HuberGiron/cnc/motores-y-mecanismos.md

---
layout: default
title: Mecanismos
nav_order: 3
---

# Motores y mecanismos de transmisión

Una CNC necesita convertir el movimiento rotativo del motor en **movimiento lineal controlado**. Esa conversión puede lograrse con distintos mecanismos, y la elección del mecanismo afecta directamente la velocidad, el empuje, la rigidez, la precisión, la longitud de recorrido y el costo del eje [1], [2].

<div class="content-media ratio-16x9">
  <iframe
    src="https://www.youtube.com/embed/OAEwRMqpst0"
    title="Video sobre motores y mecanismos CNC"
    allow="accelerometer; autoplay; clipboard-write; encrypted-media; gyroscope; picture-in-picture; web-share"
    allowfullscreen>
  </iframe>
</div>

En esta sección se comparan tres mecanismos muy comunes en máquinas CNC y automatización ligera:

- **Husillo**,
- **Banda dentada**,
- **Engrane-cremallera**.

También se aclara el papel de las **guías lineales**, ya que con frecuencia se confunden con la transmisión aunque cumplen otra función.

## 1. Motor a pasos

En máquinas CNC de prototipado es muy común usar **motores a pasos** (*stepper motors*). Se utilizan porque permiten construir sistemas de movimiento relativamente simples, económicos y suficientemente precisos para muchas tareas de posicionamiento en ejes X, Y y Z.

Motores NEMA 1

Un motor a pasos no gira “libremente” como un motor DC convencional, sino que avanza en **incrementos angulares discretos** llamados **pasos**. Internamente, el driver energiza sus bobinas en una secuencia determinada, generando campos magnéticos que hacen que el rotor avance de una posición estable a la siguiente. Por eso, cada pulso enviado al sistema produce un pequeño avance angular del eje del motor.

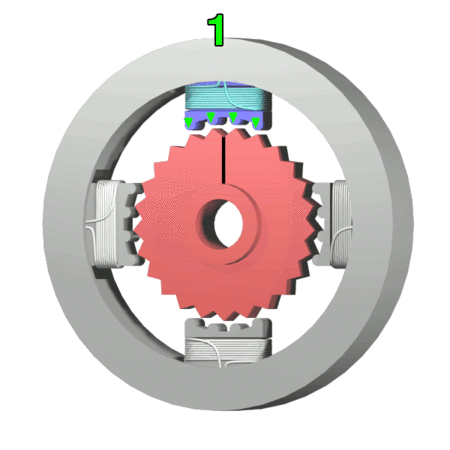
[picture p60: assets/img/mecanismos/motor_a_pasos.webp]
Motores NEMA 17


En muchos motores NEMA 17 usados en CNC, el ángulo típico por paso es de **1.8°**, lo que significa que se requieren:

- **200 pasos por vuelta** para completar 360°
- porque: **360° / 1.8° = 200**

Este concepto es fundamental en CNC, porque el controlador no mueve directamente “10 mm”; en realidad genera una cierta cantidad de pulsos. Después, mediante la transmisión mecánica, esos pasos del motor se convierten en desplazamiento lineal del eje.

### ¿Qué tienen que ver los pasos con el movimiento lineal?

El motor produce **movimiento rotativo discreto**, pero la máquina necesita **movimiento lineal controlado**. Por eso se usa un mecanismo intermedio, por ejemplo:

- **Banda dentada**
- **Husillo**
- **Piñon-cremallera**

La relación entre los pasos del motor y el desplazamiento lineal depende del mecanismo de transmisión.

Por ejemplo, si un motor de **200 pasos/vuelta** mueve una polea GT2 de **20 dientes** con banda de **2 mm de paso**, entonces una vuelta completa produce:

**20 × 2 = 40 mm/vuelta**

Por lo tanto, cada paso completo del motor desplaza idealmente:

**40 mm / 200 = 0.2 mm por paso**

### ¿Por qué se usan motores a pasos en CNC?

Los motores a pasos son muy populares en CNC educativas, de escritorio y de prototipado por varias razones:

1. **Permiten posicionamiento incremental sencillo**  
   El controlador solo necesita contar pulsos para estimar la posición del motor.

2. **Tienen buen torque a bajas velocidades**  
   Esto es útil en ejes que deben arrancar, detenerse y mantener posición con frecuencia.

3. **Pueden sostener posición cuando están energizados**  
   Esto ayuda a mantener el eje en su lugar sin necesidad de un freno mecánico adicional en muchos casos.

4. **Se integran fácilmente con controladores como GRBL**  
   Sistemas como Arduino + CNC Shield + A4988/DRV8825 generan señales STEP/DIR de forma directa y sencilla.

5. **Tienen bajo costo y gran disponibilidad**  
   Son fáciles de conseguir, documentar y reemplazar.

### Limitaciones importantes

Aunque son muy útiles, los motores a pasos también tienen limitaciones. Si se les exige demasiada velocidad, aceleración o carga, pueden **perder pasos**. Cuando eso ocurre, el controlador sigue creyendo que el eje está donde debería, pero mecánicamente ya no coincide con la posición real. Por eso, en una CNC bien ajustada es importante definir correctamente:

- Corriente del driver,
- Aceleraciones,
- Velocidad máxima,
- Tipo de transmisión,
- Masa móvil,
- Rigidez del sistema.

Por eso, al diseñar una CNC no basta con elegir un “motor potente”; hay que entender cómo sus pasos se traducen en movimiento lineal útil dentro de una arquitectura mecánica completa.

## 2. Husillo

El sistema por **husillo** convierte la rotación en avance lineal mediante un tornillo y una tuerca. En la práctica pueden encontrarse variantes como **lead screw**, **Acme** y **ball screw**. Cada vuelta del eje produce un avance lineal determinado por el paso o el lead del tornillo [1].

### Ventajas típicas del husillo

- Buen empuje axial,
- Buena relación entre rotación y avance,
- Buena rigidez para recorridos cortos o medianos,
- Buena solución cuando importa más el control del avance que la velocidad máxima.

### Limitaciones típicas del husillo

- Menor velocidad que una banda en recorridos largos,
- Restricciones por velocidad crítica en tornillos largos,
- Mayor sensibilidad a desalineación,
- Menor conveniencia cuando el recorrido crece mucho.

En general, el husillo suele ser una solución atractiva cuando se busca mayor capacidad de carga, mejor control del avance o una respuesta más rígida que la de una banda [1], [3].

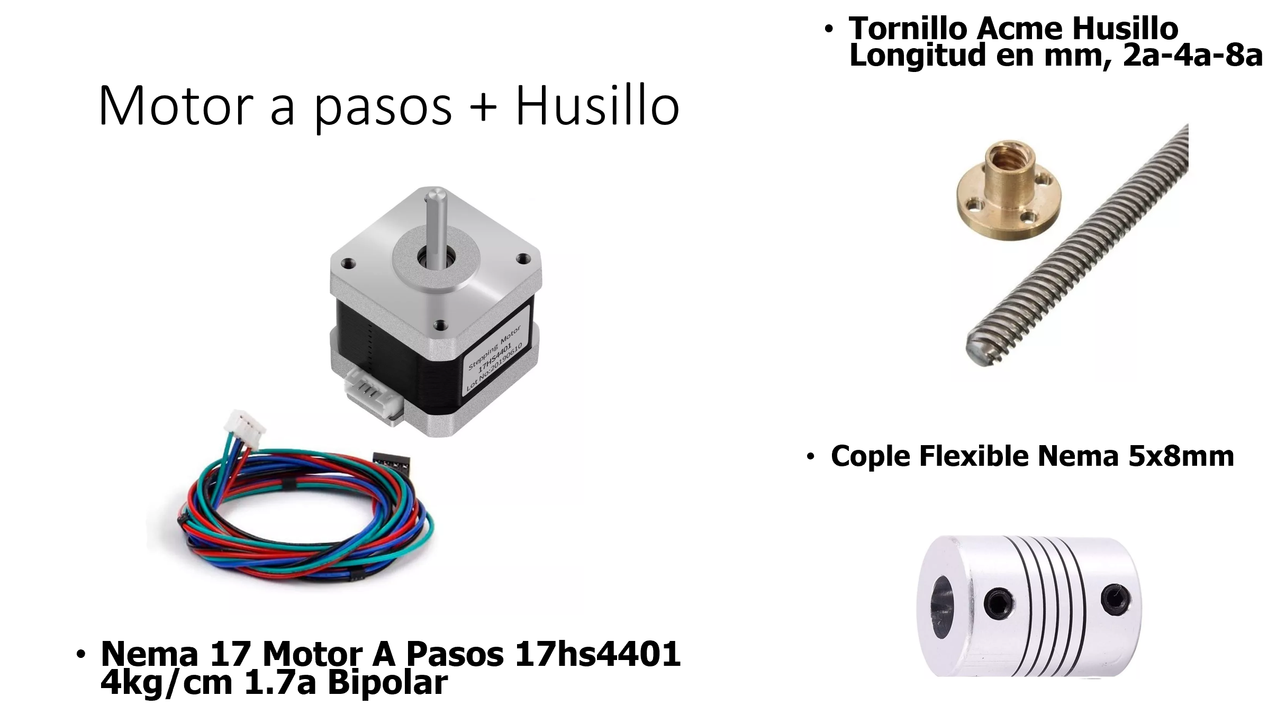
[picture p61: assets/img/mecanismos/componentes_husillo.png]
Componentes Husillo


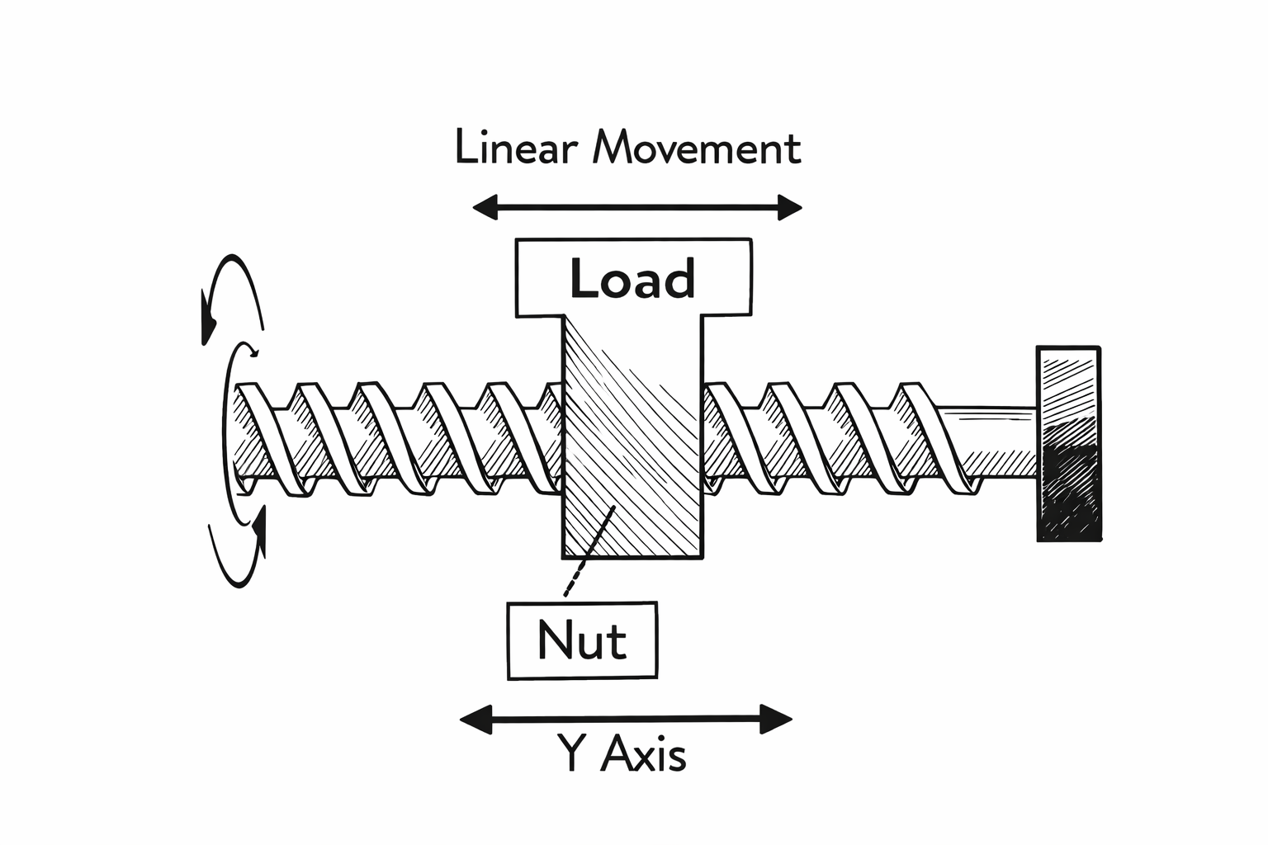
[picture p62: assets/img/mecanismos/husillo2.png]
Husillo


## 3. Banda dentada

En un sistema por **banda dentada**, el motor mueve una polea y la polea arrastra una banda sincronizada que desplaza el carro. Es una solución muy común en ejes largos y ligeros porque es simple, rápida y fácil de integrar [1].

### Ventajas típicas de la banda

- Alta velocidad,
- Buena aceleración,
- Buena solución para recorridos largos,
- Menor masa rotacional que un husillo largo,
- Costo relativamente accesible.

### Limitaciones típicas de la banda

- Menor rigidez que un husillo o algunas soluciones por cremallera,
- Sensibilidad a la tensión de banda,
- Posibilidad de elongación o elasticidad del sistema,
- Menor empuje axial disponible.

Por eso la banda dentada es muy común en routers ligeros, plotters, cortadoras y mecanismos donde interesa más la dinámica del eje que el empuje máximo [1], [2].

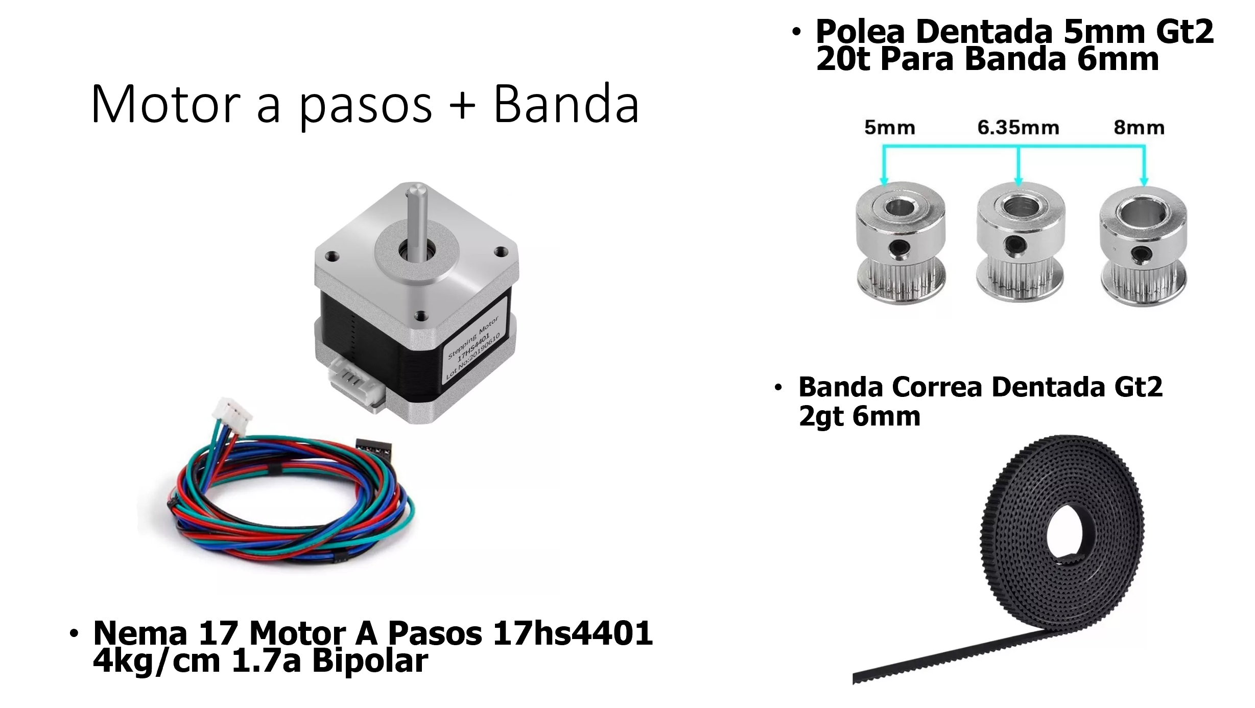
[picture p63: assets/img/mecanismos/componentes_banda.png]
Componentes Banda


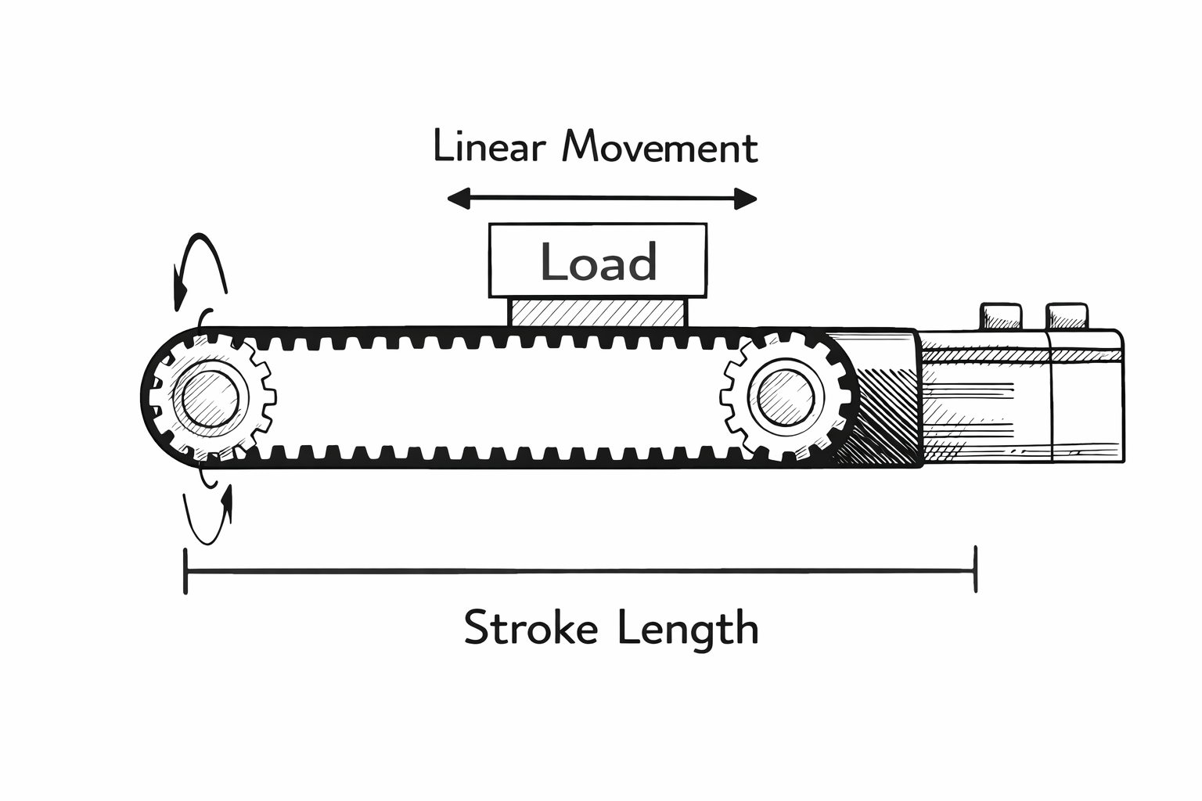
[picture p64: assets/img/mecanismos/banda.png]
Banda


## 4. Piñon-cremallera

El sistema de **piñon-cremallera** usa un piñón rotativo acoplado a una barra dentada lineal. Esta solución es muy utilizada cuando el recorrido se vuelve demasiado largo para que el husillo sea conveniente o cuando se requieren ejes largos, dinámicos y robustos [2], [4].

### Ventajas típicas de la cremallera

- Buena solución para largos recorridos,
- Buena rigidez estructural del sistema,
- Buen desempeño dinámico,
- Posibilidad de sistemas precargados para reducir backlash.

### Limitaciones típicas de la cremallera

- Mayor complejidad mecánica,
- Necesidad de buena alineación,
- Atención al backlash si no se precarga,
- Mayor costo que soluciones simples de banda en máquinas ligeras.

En aplicaciones industriales, la cremallera se vuelve muy competitiva cuando la longitud del eje es alta y la máquina necesita conservar rigidez y repetibilidad [4].

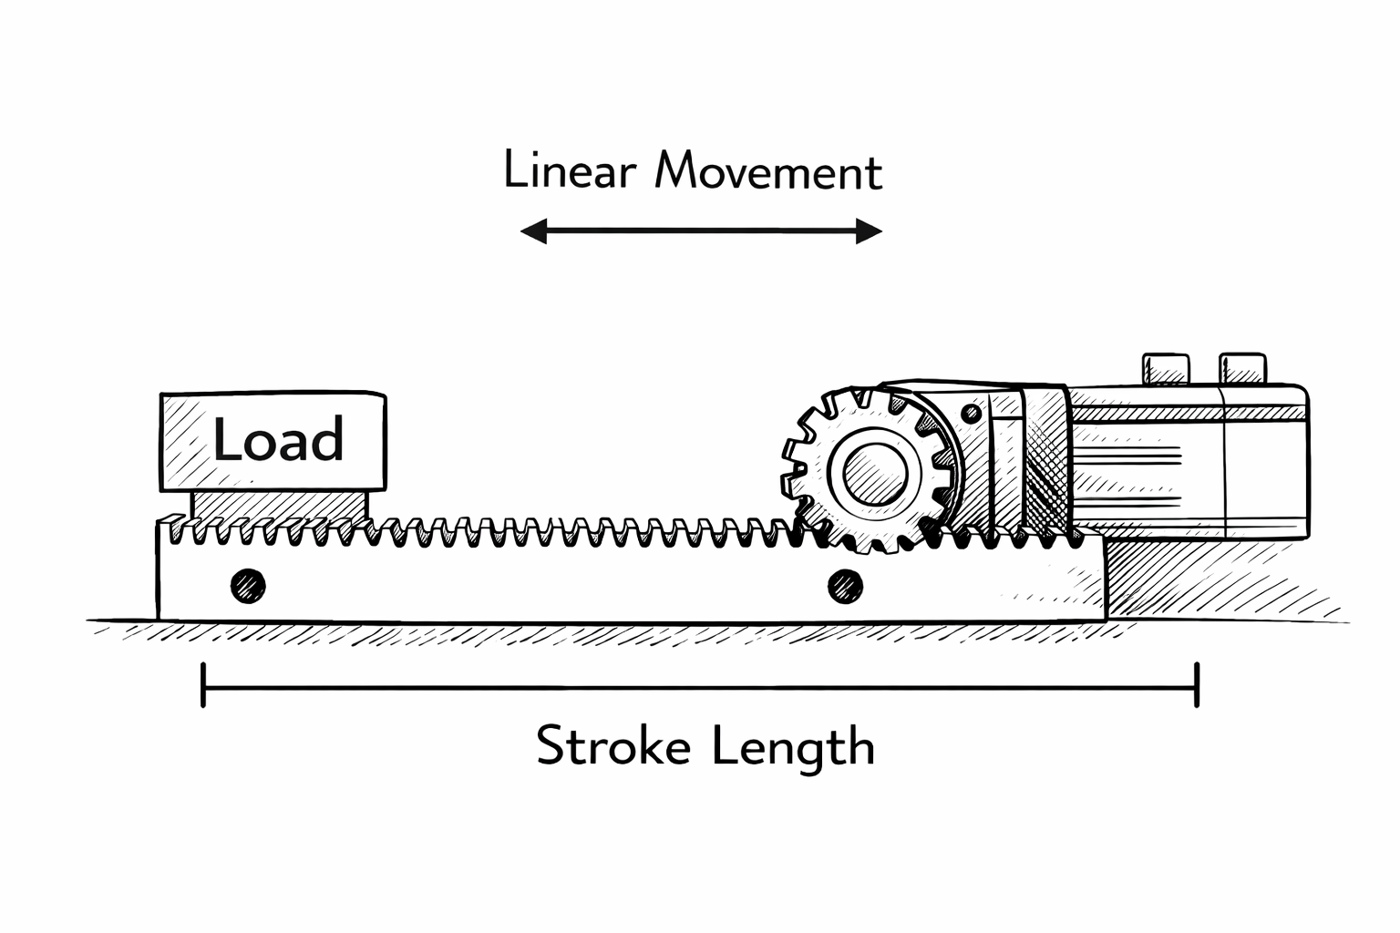
[picture p65: assets/img/mecanismos/cremallera.png]
Cremallera


## 5. Guías lineales

Un punto fundamental: las **guías lineales** no generan el movimiento, sino que **restringen** el movimiento a una trayectoria recta. THK describe este tipo de elementos como componentes lineales que usan principios de rodamientos para mover objetos en línea recta con baja fricción y buena capacidad de carga [5].

Eso significa que un eje lineal completo normalmente tiene al menos dos subsistemas:

- Un sistema de **guiado**,
- Un sistema de **accionamiento**.

Por ejemplo:

- Guía lineal + Husillo,
- Varilla lisa + Carro lineal + Banda,
- Riel + Carro + Cremallera.

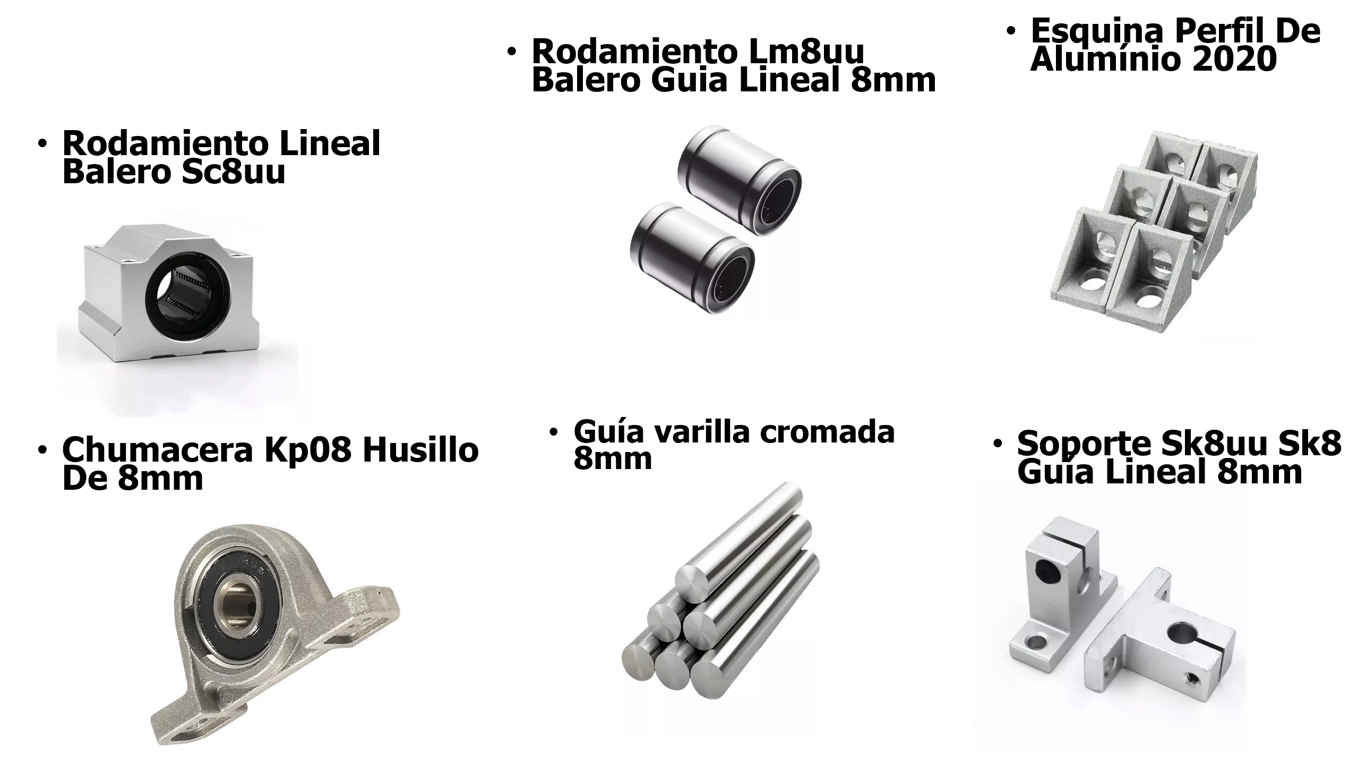
[picture p66: assets/img/mecanismos/componentes_guia.png]
Componentes


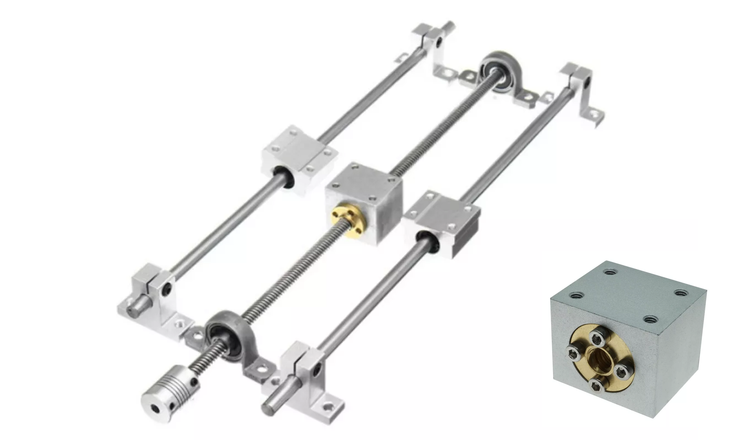
[picture p67: assets/img/mecanismos/husillo.png]


## 6. Comparación rápida

| Mecanismo | Punto fuerte principal | Limitación típica | Uso común |
|---|---|---|---|
| Husillo | Empuje y control del avance | Menor velocidad en recorridos largos | Z, ejes cortos o de mayor rigidez |
| Banda dentada | Velocidad y aceleración | Menor rigidez / elasticidad | X o Y en máquinas ligeras |
| Engrane-cremallera | Recorrido largo y rigidez | Mayor complejidad y costo | Movimiento robusto o de precisión |

## 7. Criterio práctico de selección

Una forma útil de seleccionar el mecanismo es hacerte estas preguntas:

- ¿Qué tan largo será el eje?
- ¿Qué masa se moverá?
- ¿Qué tan importante es la velocidad?
- ¿Qué tan importante es la fuerza axial?
- ¿Qué tan importante es la rigidez?
- ¿La máquina va a dibujar, cortar, grabar o fresar material con esfuerzo real?

## Referencias

[1] Tolomatic, “Screw-driven vs. belt-driven rodless actuators: How to select drive trains for reliability, efficiency and long service life,” 2026. [En línea]. Disponible en: https://www.tolomatic.com/info-center/resource-details/screw-vs-belt-rodless-actuators-selecting-drive-trains/

[2] Tecnotion, “Comparison of linear motors and other drive systems,” 2026. [En línea]. Disponible en: https://www.tecnotion.com/comparison-of-linear-motors-and-other-drive-systems/

[3] Tolomatic, *Screw-Driven vs. Belt-Driven Rodless Actuators*, PDF técnico. [En línea]. Disponible en: https://www.tolomatic.com/wp-content/uploads/2022/05/9900-9210_screw-vs-belt-actuators-2021.pdf

[4] Nidec Drive Technology Corporation, “Applying Rack and Pinion in Linear Drive Systems,” 2026. [En línea]. Disponible en: https://www.nidec-dtc.com/applying-rack-and-pinion-in-linear-drive-systems/

[5] THK Co., Ltd., “Linear Guides (Linear Motion Guides) Design and Selection,” 2026. [En línea]. Disponible en: https://www.thk.com/opm/jp/en/linear/thklinearguide/

---

## Siguiente sección

[Diseño mecánico de esta CNC](diseno-mecanico-cnc.md)
