HuberGiron/cnc/assets/img/arquitectura/cnc-digital.png

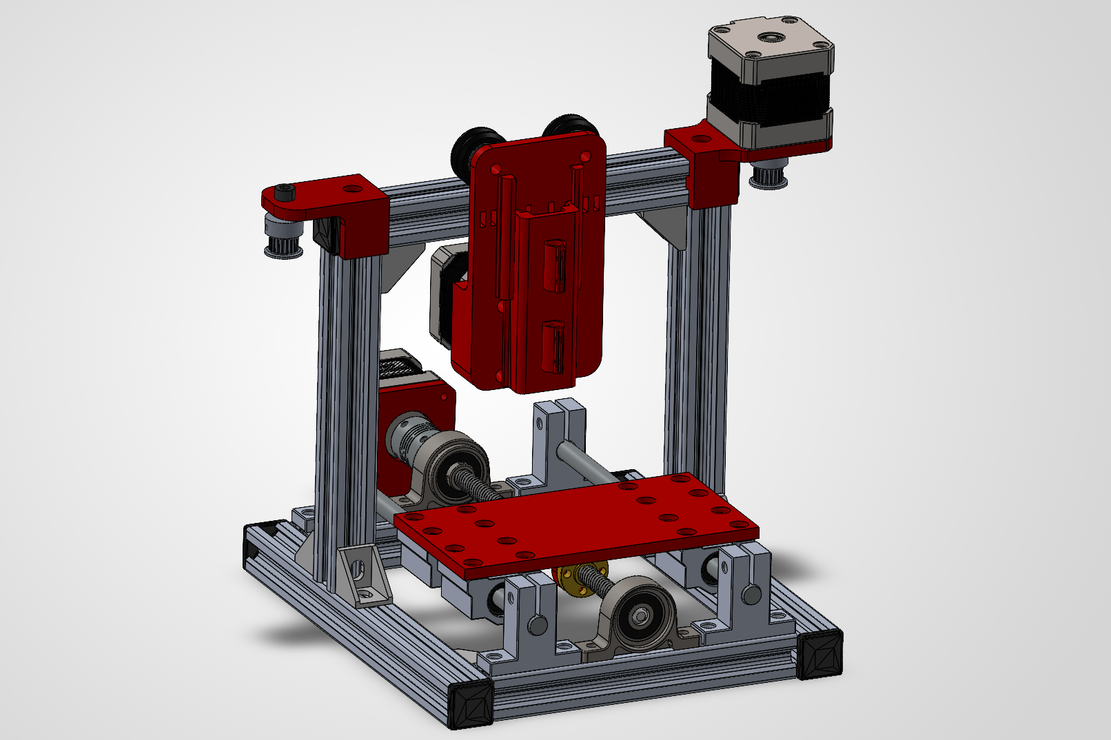
assets/img/arquitectura/cnc-digital.png
