HuberGiron/cnc/assets/img/G_code/circulo.png

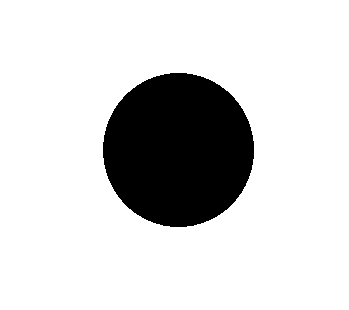
assets/img/G_code/circulo.png
