HuberGiron/cnc/assets/img/G_code/IBERO.png

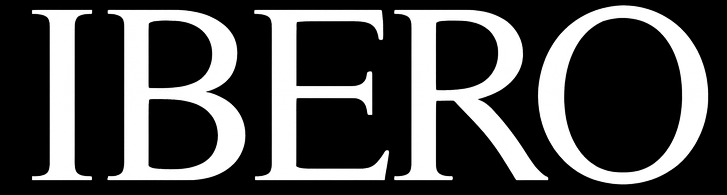
assets/img/G_code/IBERO.png
