HuberGiron/cnc/assets/img/G_code/lobo.png

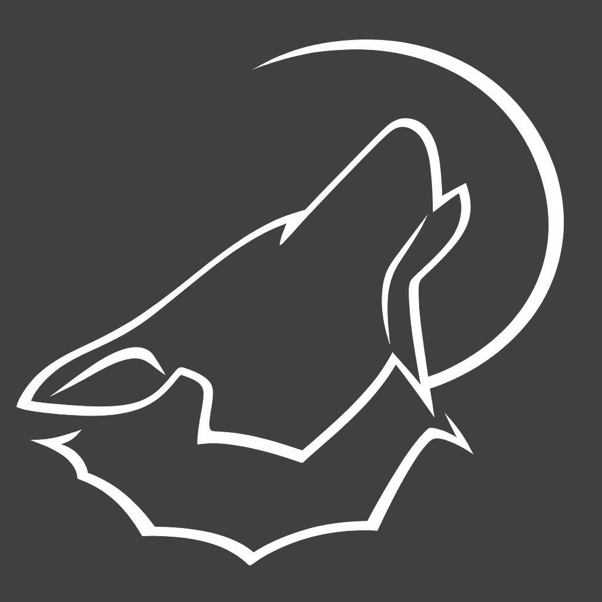
assets/img/G_code/lobo.png
