HuberGiron/cnc/assets/img/guardado.png

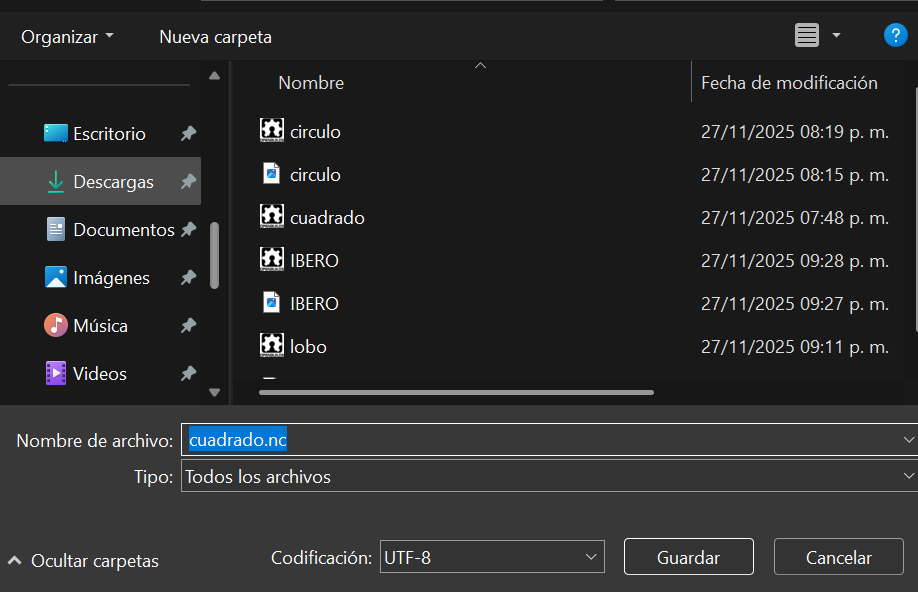
assets/img/guardado.png
