HuberGiron/cnc/assets/img/mecanica/14.JPG

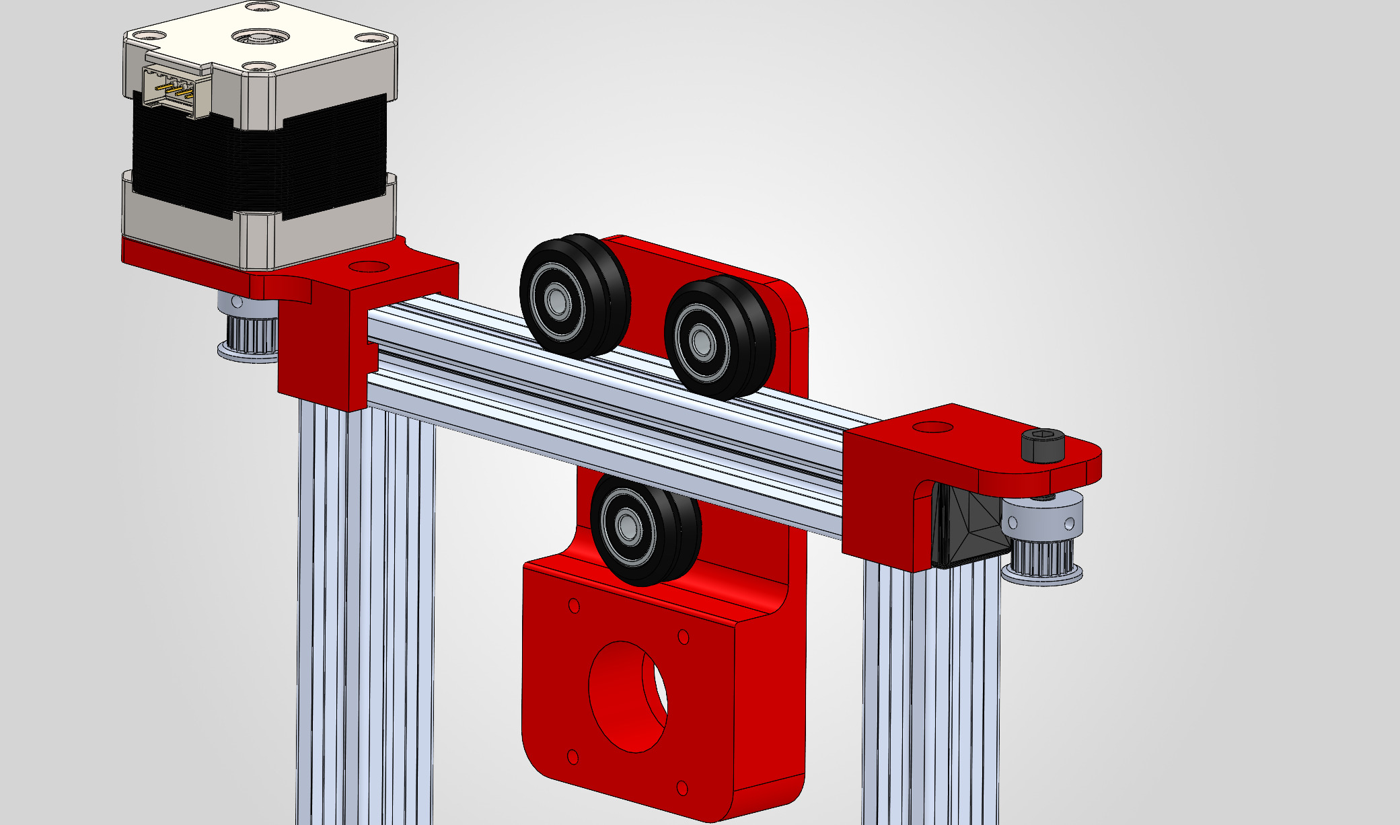
assets/img/mecanica/14.JPG
