HuberGiron/cnc/assets/img/mecanica/21.JPG

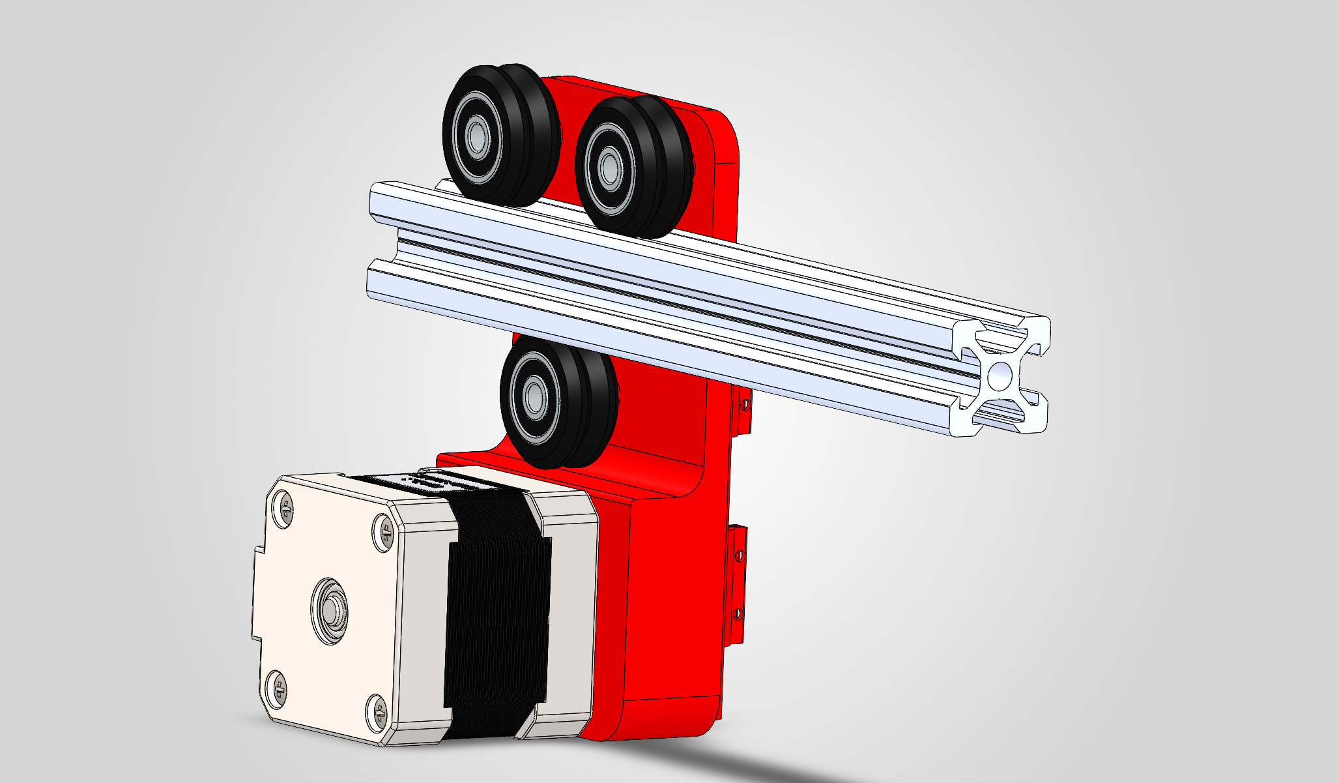
assets/img/mecanica/21.JPG
