HuberGiron/cnc/assets/img/mecanica/26.JPG

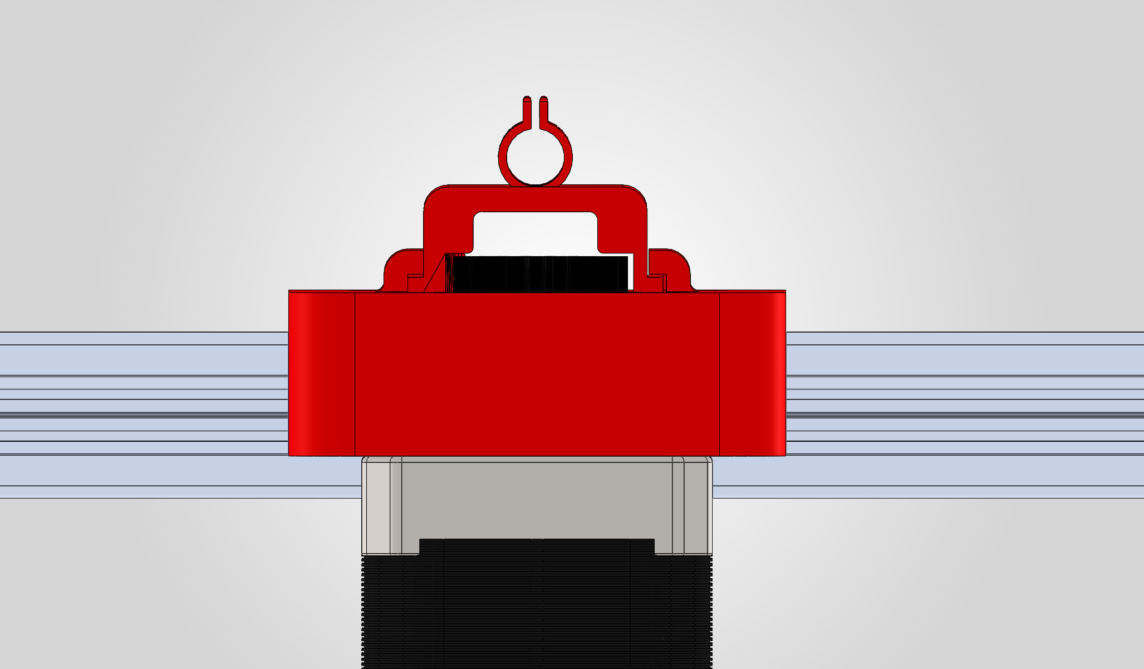
assets/img/mecanica/26.JPG
