HuberGiron/cnc/assets/img/mecanica/28.JPG

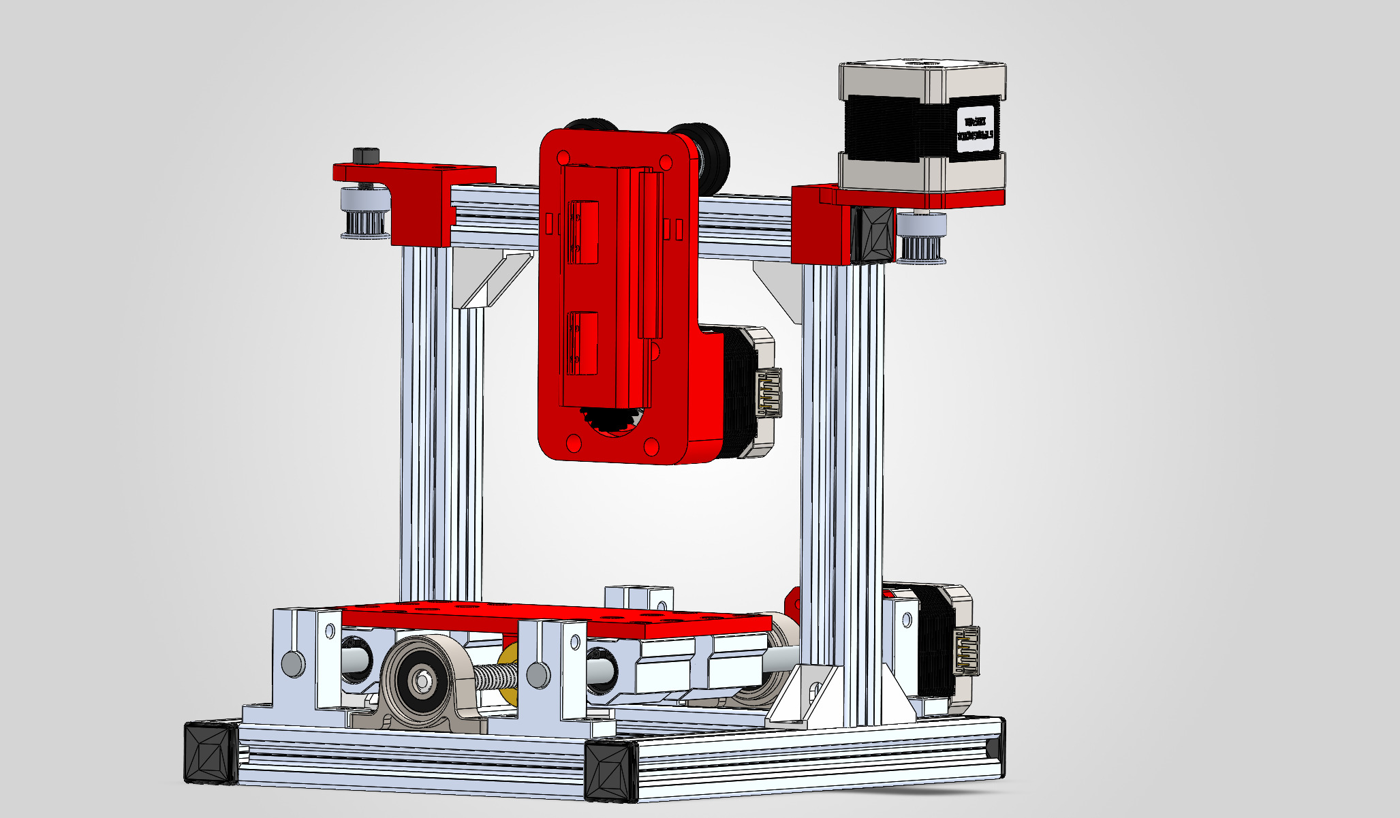
assets/img/mecanica/28.JPG
