HuberGiron/cnc/assets/files/stl/Estructura_tapa_2020.stl

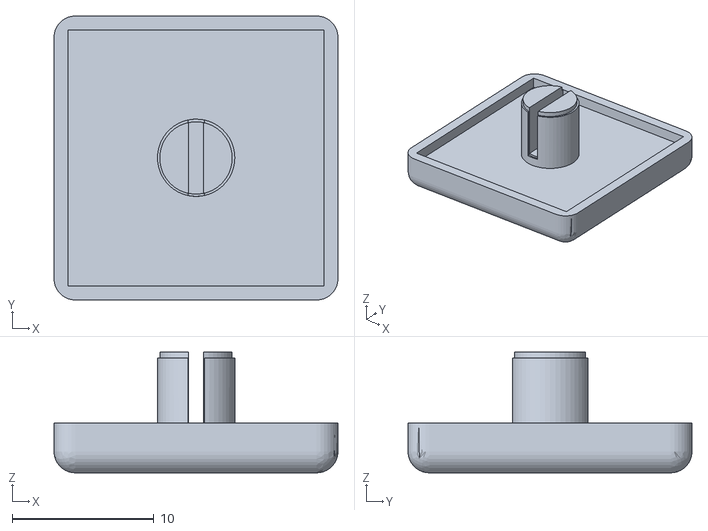
[picture p88: CAD file, 2026-03-13]
assets/files/stl/Estructura_tapa_2020.stl
20.0 x 20.0 x 8.50
