HuberGiron/cnc/mods/test/sample.wide.stl

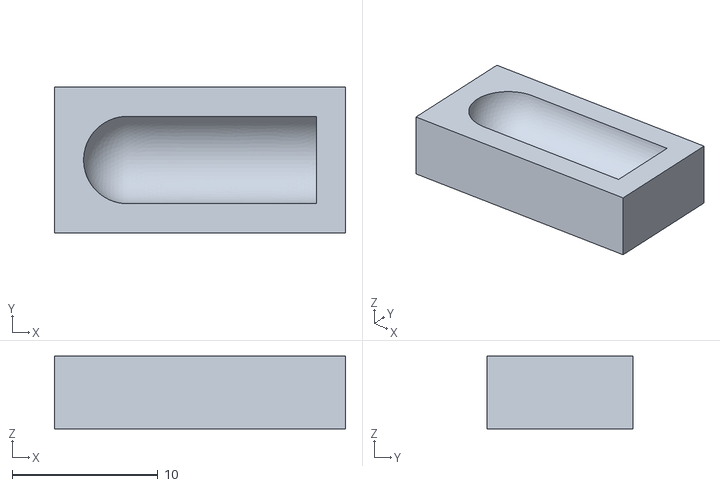
[picture p89: CAD file, 2025-12-02]
mods/test/sample.wide.stl
20.0 x 10.0 x 5.00
