HuberGiron/cnc/assets/files/stl/EjeX_Base_motor_arriba.STL

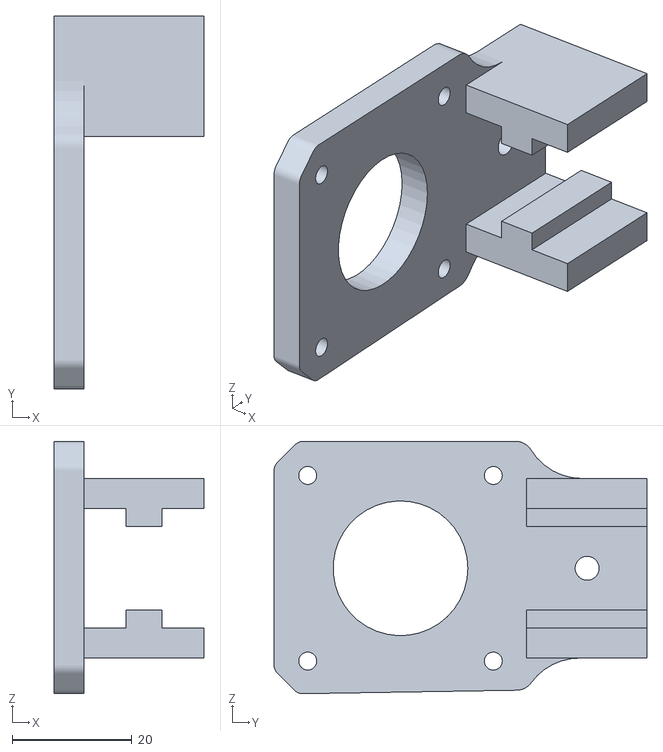
[picture p90: CAD file, 2026-03-13]
assets/files/stl/EjeX_Base_motor_arriba.STL
25.0 x 62.3 x 42.2
