HuberGiron/cnc/assets/files/stl/EjeX_Base_tornillo_arriba.STL

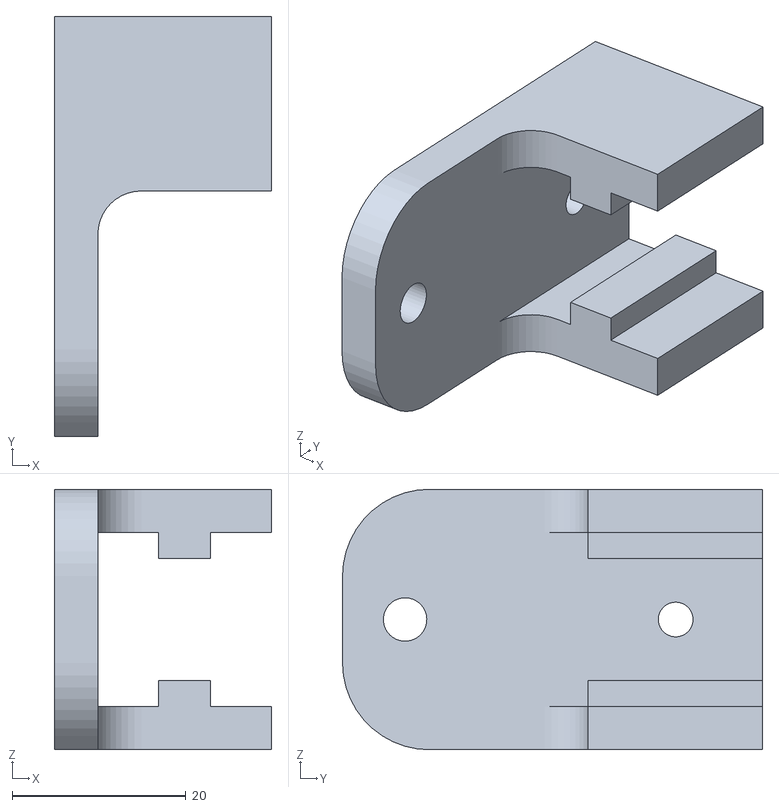
[picture p91: CAD file, 2026-03-13]
assets/files/stl/EjeX_Base_tornillo_arriba.STL
25.0 x 48.4 x 30.0
