HuberGiron/cnc/mods/test/sample.fcstd

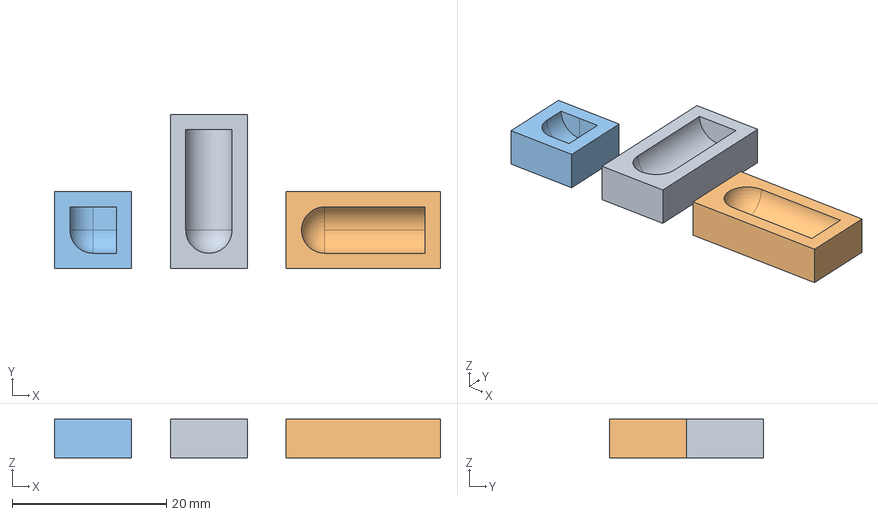
[picture p92: CAD file, 2025-12-02]
mods/test/sample.fcstd
50.0 x 20.0 x 5.00 mm
