HuberGiron/cnc/assets/files/stl/EjeY_Base_motor_abajo.STL

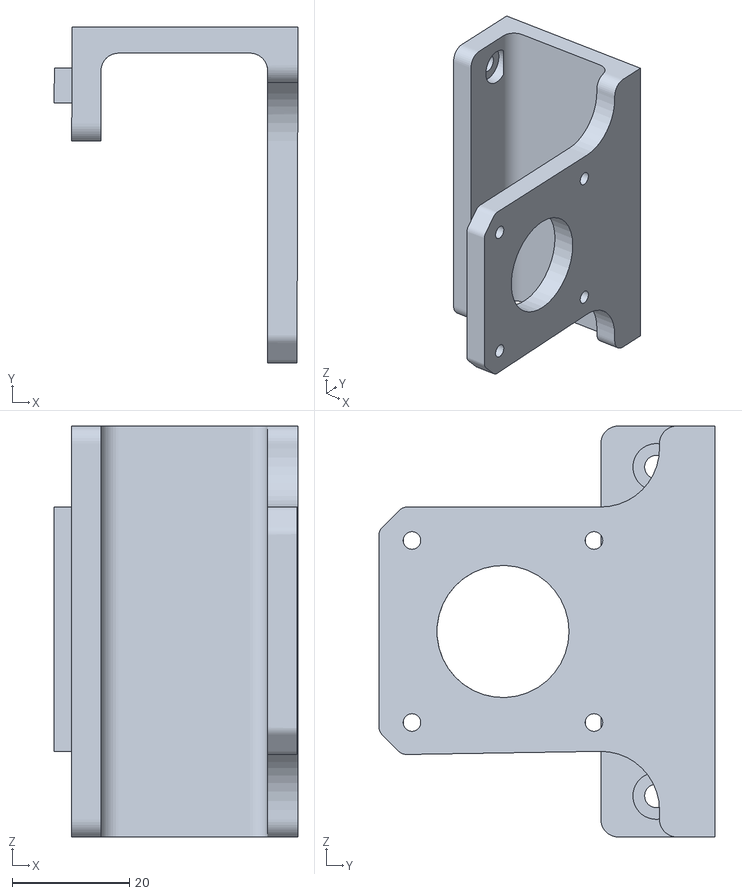
[picture p93: CAD file, 2026-03-13]
assets/files/stl/EjeY_Base_motor_abajo.STL
41.5 x 57.3 x 70.0
