HuberGiron/cnc/mods/test/Suzanne.stl

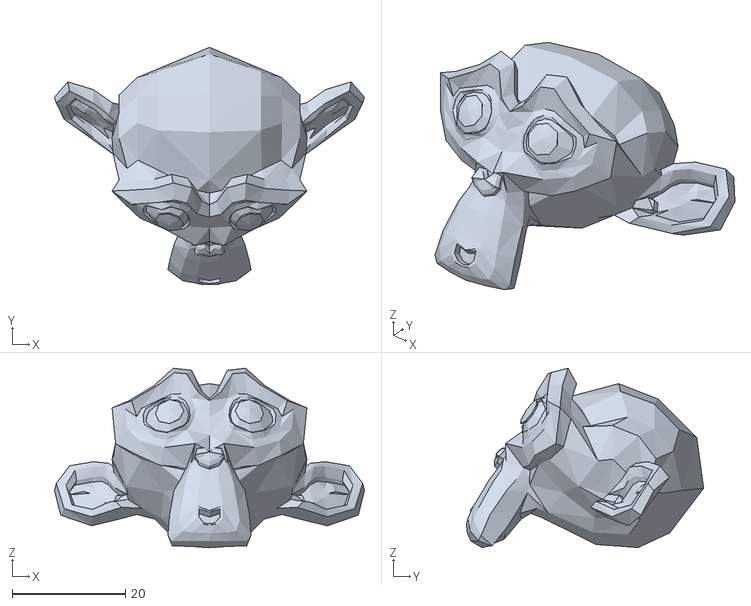
[picture p94: CAD file, 2025-12-02]
mods/test/Suzanne.stl
54.7 x 41.9 x 31.7
