HuberGiron/cnc/assets/files/stl/EjeZ_engrane.STL

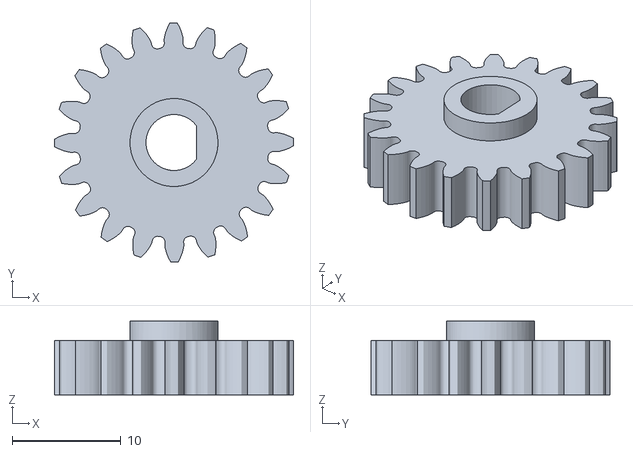
[picture p95: CAD file, 2026-03-13]
assets/files/stl/EjeZ_engrane.STL
22.0 x 22.0 x 6.80
