HuberGiron/cnc/assets/files/stl/EjeZ_cremallera.STL

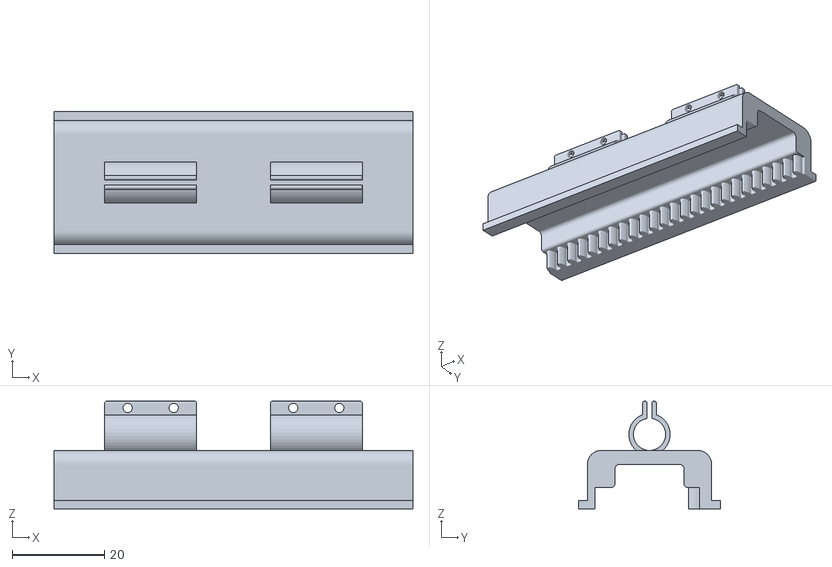
[picture p96: CAD file, 2026-03-13]
assets/files/stl/EjeZ_cremallera.STL
78.0 x 30.8 x 23.4
