HuberGiron/cnc/assets/files/stl/Estructura_Base_electronica.STL

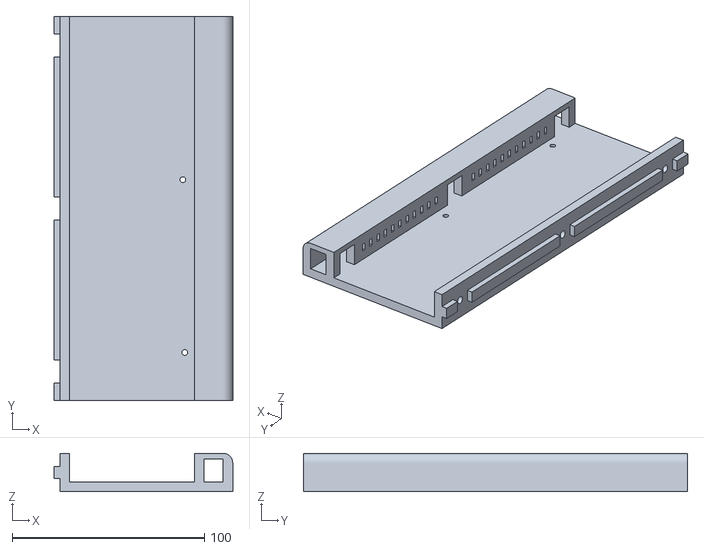
[picture p97: CAD file, 2026-03-13]
assets/files/stl/Estructura_Base_electronica.STL
93.0 x 200.0 x 20.0
