HuberGiron/cnc/assets/files/stl/EjeY_base_abajo.STL

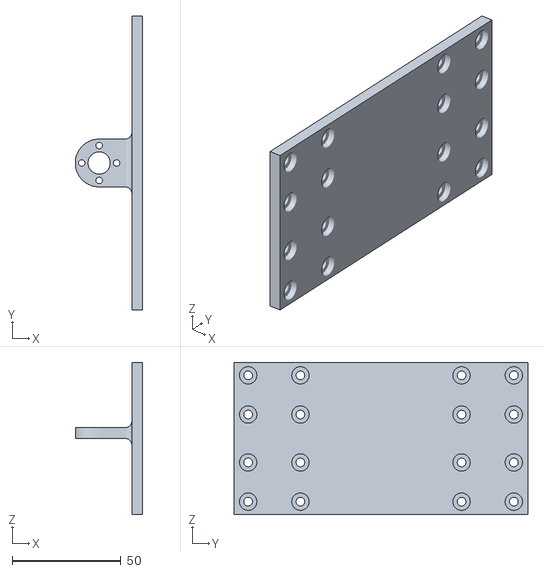
[picture p98: CAD file, 2026-03-13]
assets/files/stl/EjeY_base_abajo.STL
31.0 x 135.0 x 70.0
