HuberGiron/cnc/assets/files/stl/EjeX_Base_carroBanda.STL

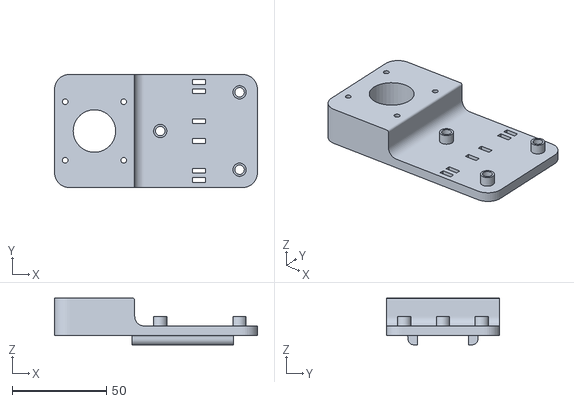
[picture p99: CAD file, 2026-03-13]
assets/files/stl/EjeX_Base_carroBanda.STL
107.5 x 60.0 x 24.7
