HuberGiron/cnc/(list of files, cad)

Other CAD files:
mods/test/sample.tall.stl
mods/test/sample.stl
