HuberGiron/cnc/mods/test/ForestBeing.png

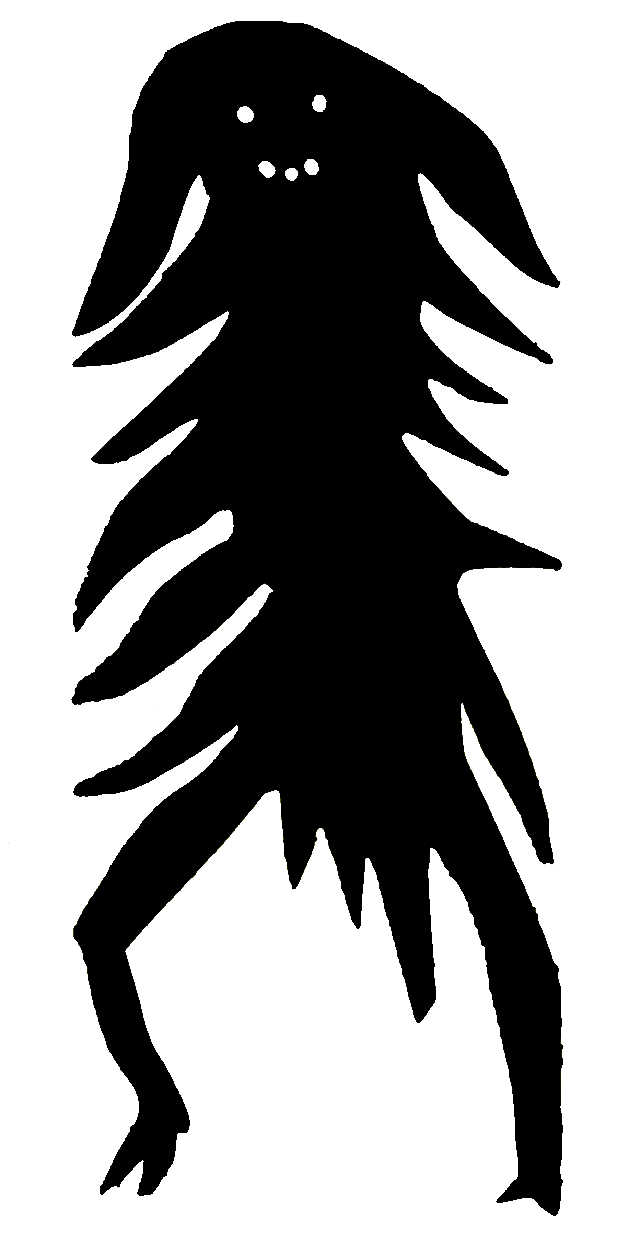
mods/test/ForestBeing.png
