HuberGiron/cnc/(commit log)

2025-12-01 grbl zip
2025-12-02 mill 2D
2025-12-02 uso de ia
2026-03-13 motor nema
2026-03-13 animacion motor
2026-03-13 diseño v1
    [EjeX_Base_carroBanda.STL, EjeX_Base_motor_arriba.STL, EjeX_Base_tornillo_arriba.STL, EjeY_Base_motor_abajo.STL, EjeY_base_abajo.STL, EjeZ_cremallera.STL, EjeZ_engrane.STL, Estructura_Base_electronica.STL]
2026-03-13 MAS CAMBIOS DISEÑO MECANICO
    [Estructura_tapa_2020.stl]
2026-03-13 CAMBIOS BOM
2026-03-13 REDIRECCION STL
